UCI-CubeSat/EPS-Hardware/(list of files, drawings)

Other design files:
UCI EPS Design Files (2023-24)/EPS 2023-24.PrjPcb/Source Documents/EPS 2023-24.PcbDoc
UCI EPS Design Files (2023-24)/EPS 2023-24.PrjPcb/Source Documents/EPS 2023-24.PrjPcb
UCI EPS Design Files (2023-24)/EPS 2023-24.PrjPcb/Source Documents/EPS_Headers.SchDoc
UCI EPS Design Files (2023-24)/EPS 2023-24.PrjPcb/Source Documents/PAH_Deployments.SchDoc
UCI EPS Design Files (2023-24)/EPS 2023-24.PrjPcb/Source Documents/SolarPanel_PowerGeneration.SchDoc
UCI EPS Design Files (2023-24)/EPS 2023-24.PrjPcb/Source Documents/STM32_IO.SchDoc
UCI EPS Design Files (2023-24)/EPS 2023-24.PrjPcb/Source Documents/System_VoltageControl.SchDoc
UCI EPS Design Files (2023-24)/EPS 2023-24.PrjPcb/Source Documents/TEST_SchematicHierarchy.SchDoc
UCI EPS Design Files (2023-24)/EPS 2023-24.PrjPcb/Source Documents/Voltage_BypassCapacitors.SchDoc
